ESCA47/ProGCCv3-hhlprotos/(list of files, cad)

Other CAD files:
progcc_v3_libs/docs/guilikit source materials/GL18 GuliKit Electromagnetic joystick PCB package library/GL18 Joystick.DWG
