ESCA47/ProGCCv3-hhlprotos/progcc_v3_main/procon_gcc_main_pcb.kicad_pcb

## KiCad design progcc_v3_main/procon_gcc_main_pcb.kicad_pcb (2023-06-27)

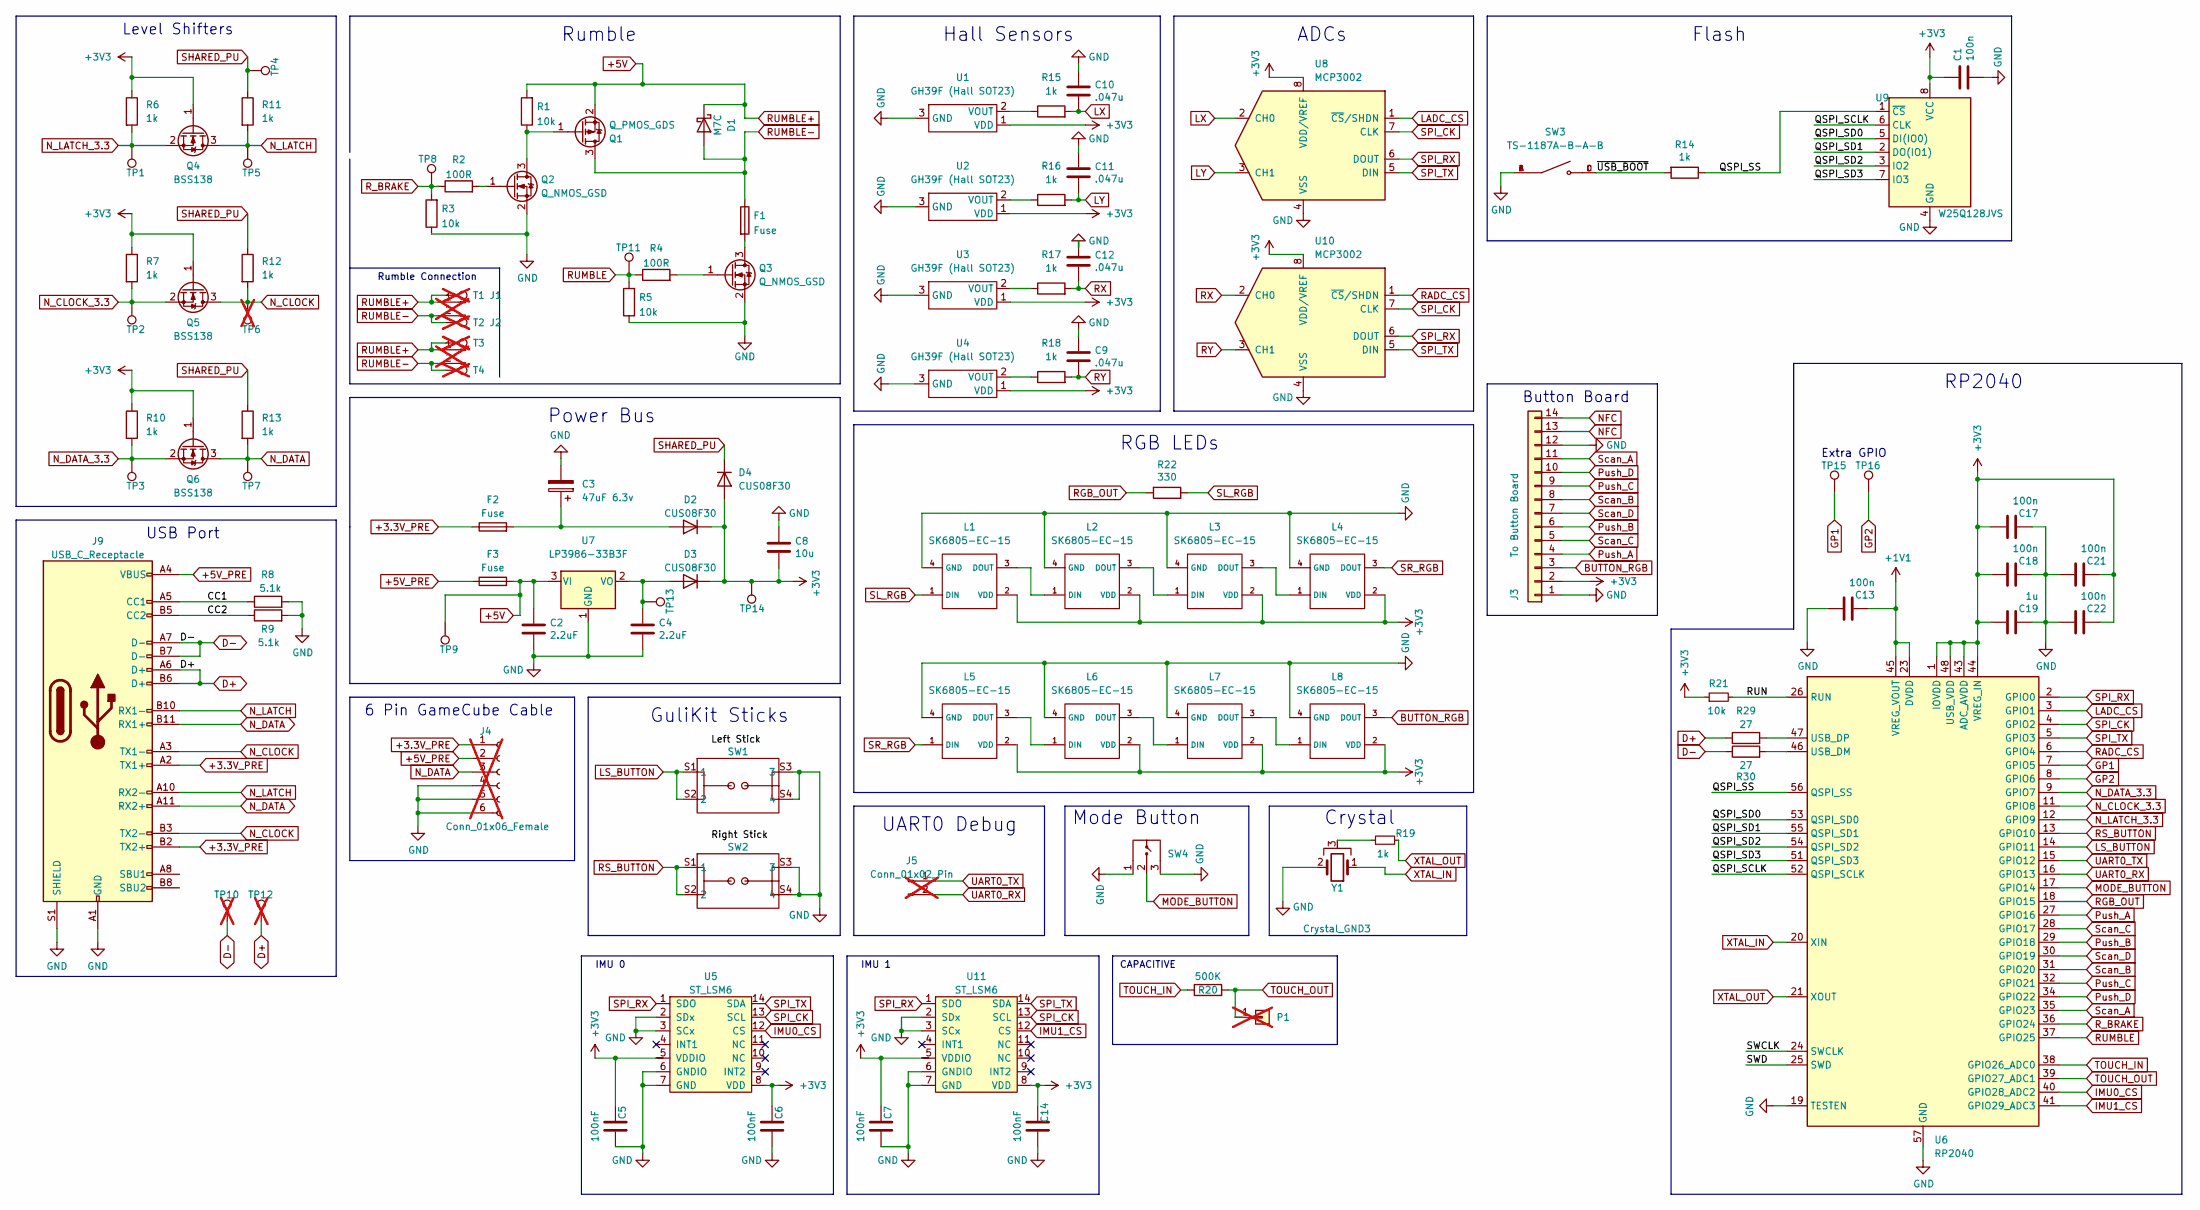
[picture p1: schematic procon_gcc_main_pcb.kicad_sch, ProGCC v3 Main Board]

Parts:
C1, C13, C17, C18, C21, C22: 100n; C_0402_1005Metric
C2, C4: 2.2uF; C_0603_1608Metric
C3: 47uF 6.3v; CP_EIA-3216-18_Kemet-A
C5, C6, C7, C14: 100nF; C_0603_1608Metric; LCSC C1525
C8: 10u; C_0603_1608Metric
C9, C10, C11, C12: .047u; C_0603_1608Metric_Pad1.08x0.95mm_HandSolder; LCSC C15849
C19: 1u; C_0402_1005Metric
D1: M7C; D_SOD-123; MPN B5819W SL; LCSC C8598
D2, D3, D4: CUS08F30; D_SOD-323_HandSoldering; MPN CUS08F30
F1, F2, F3: Fuse; Fuse_1206_3216Metric_Pad1.42x1.75mm_HandSolder; LCSC C69680
J1, J2: Rumble; rumble_pins; not fitted
J3: To Button Board; molex_5051101492_14P; MPN molex_5051101492_14P
J4: Conn_01x06_Female; GCC_Header_Straight_1x06_Pitch2.00mm; not fitted
J5: Conn_01x02_Pin; PinHeader_1x02_P2.00mm_Vertical; not fitted
J9: USB_C_Receptacle; Shou Han Type-C 24P QCHT; MPN Shou Han Type-C 24P QCHT
L1, L2, L3, L4, L5, L6, L7, L8: SK6805-EC-15; MPN SK6805-EC-15
P1: Endpoint; PinHeader_1x01_P2.54mm_Vertical; not fitted
Q1: Q_PMOS_GDS; SOT-23; MPN AO3401A; LCSC C15127
Q2, Q3: Q_NMOS_GSD; SOT-23; MPN AO3400A; LCSC C20917
Q4, Q5, Q6: BSS138; SOT-23; MPN BSS138
R1, R3, R5: 10k; R_0402_1005Metric; LCSC C25804
R2, R4: 100R; R_0402_1005Metric; LCSC C22775
R6, R7, R10, R11, R12, R13: 1k; R_0603_1608Metric_Pad0.98x0.95mm_HandSolder
R8, R9: 5.1k; R_0603_1608Metric_Pad0.98x0.95mm_HandSolder
R14, R15, R16, R17, R18, R19: 1k; R_0402_1005Metric
R20: 500K; R_0402_1005Metric; LCSC C11616
R21: 10k; R_0402_1005Metric
R22: 330; R_0402_1005Metric
R29, R30: 27; R_0402_1005Metric
SW1, SW2: GL18_SW; GL18; MPN GL18
SW3: TS-1187A-B-A-B; SW_TS-1187A-B-A-B; PARTREV A0
SW4: TS35CA; MPN TS35CA
T1, T2, T3, T4: 36-8730; KS_8730; not fitted
TP1, TP2, TP3, TP4, TP5, TP7, TP8, TP9, TP11, TP13, TP14, TP15, TP16: TestPoint; TestPoint_Pad_D1.5mm
TP6, TP10, TP12: TestPoint; TestPoint_Pad_D1.5mm; not fitted
U1, U2, U3, U4: GH39F (Hall SOT23); GH39F; MPN GH39F
U5, U11: ST_LSM6; LGA14; MPN LSM6DSRTR; LCSC C784817
U6: RP2040; QFN-56-1EP_7x7mm_P0.4mm_EP3.2x3.2mm; MPN RP2040
U7: LP3986-33B3F; SOT-23; MPN LP3986-33B3F; LCSC Part Number C387689
U8, U10: MCP3002; SOIC-8_3.9x4.9mm_P1.27mm; MPN MCP3002
U9: W25Q128JVS; SOIC-8_5.23x5.23mm_P1.27mm; MPN W25Q128JVS
Y1: Crystal_GND3; Resonator_SMD_Murata_CSTxExxV-3Pin_3.0x1.1mm; MPN CSTNE12M0GH5L000R0

Connections:
+1V1: C13.2, U6.23 (DVDD), U6.45 (VREG_VOUT), U6.50 (DVDD)
+3.3V_PRE: F2.1, J4.1, J9.A2 (TX1+), J9.B2 (TX2+)
+3V3: C1.1, C5.2, C6.2, C7.2, C8.2, C14.2, C17.1, C18.1, C19.1, C21.2, C22.2, D2.1 (K), D3.1 (K), D4.2 (A), J3.2, L1.2 (VDD), L2.2 (VDD), L3.2 (VDD), L4.2 (VDD), L5.2 (VDD), L6.2 (VDD), L7.2 (VDD), L8.2 (VDD), Q4.1 (G), Q5.1 (G), Q6.1 (G), R6.1, R7.1, R10.1, R21.1, TP14.1, U1.1 (VDD), U2.1 (VDD), U3.1 (VDD), U4.1 (VDD), U5.5 (VDDIO), U5.8 (VDD), U6.1 (IOVDD), U6.10 (IOVDD), U6.22 (IOVDD), U6.33 (IOVDD), U6.42 (IOVDD), U6.43 (ADC_AVDD), U6.44 (VREG_IN), U6.48 (USB_VDD), U6.49 (IOVDD), U8.8 (VDD/VREF), U9.8 (VCC), U10.8 (VDD/VREF), U11.5 (VDDIO), U11.8 (VDD)
+5V: C2.1, D1.1 (K), F3.2, J1.1, J2.1, Q1.2 (S), R1.2, T1.1, T3.1, TP9.1, U7.3 (VI)
+5V_PRE: F3.1, J4.2, J9.A4 (VBUS), J9.A9 (VBUS), J9.B4 (VBUS), J9.B9 (VBUS)
/CC1: J9.A5 (CC1), R8.1
/CC2: J9.B5 (CC2), R9.1
/QSPI_SCLK: U6.52 (QSPI_SCLK), U9.6 (CLK)
/QSPI_SD0: U6.53 (QSPI_SD0), U9.5 (DI(IO0))
/QSPI_SD1: U6.55 (QSPI_SD1), U9.2 (DO(IO1))
/QSPI_SD2: U6.54 (QSPI_SD2), U9.3 (IO2)
/QSPI_SD3: U6.51 (QSPI_SD3), U9.7 (IO3)
/QSPI_SS: R14.1, U6.56 (QSPI_SS), U9.1 (~CS)
/RUN: R21.2, U6.26 (RUN)
/SWCLK: U6.24 (SWCLK)
/SWD: U6.25 (SWD)
/~USB_BOOT: R14.2, SW3.C, SW3.D
BUTTON_RGB: J3.3, L8.3 (DOUT)
D+: J9.A6 (D+), J9.B6 (D+), R29.1, TP12.1
D-: J9.A7 (D-), J9.B7 (D-), R30.1, TP10.1
GND: C1.2, C2.2, C3.2, C4.2, C5.1, C6.1, C7.1, C8.1, C9.1, C10.1, C11.1, C12.1, C13.1, C14.1, C17.2, C18.2, C19.2, C21.1, C22.1, J3.1, J3.12, J4.4, J4.5, J4.6, J9.A1 (GND), J9.A12 (GND), J9.B1 (GND), J9.B12 (GND), J9.S1 (SHIELD), L1.4 (GND), L2.4 (GND), L3.4 (GND), L4.4 (GND), L5.4 (GND), L6.4 (GND), L7.4 (GND), L8.4 (GND), Q2.2 (S), Q3.2 (S), R3.1, R5.1, R8.2, R9.2, SW1.S3 (3), SW1.S4 (4), SW2.S3 (3), SW2.S4 (4), SW3.A, SW3.B, SW4.1, SW4.3, U1.3 (GND), U2.3 (GND), U3.3 (GND), U4.3 (GND), U5.2 (SDx), U5.3 (SCx), U5.6 (GNDIO), U5.7 (GND), U6.19 (TESTEN), U6.57 (GND), U7.1 (GND), U8.4 (VSS), U9.4 (GND), U10.4 (VSS), U11.2 (SDx), U11.3 (SCx), U11.6 (GNDIO), U11.7 (GND), Y1.2
GP1: TP15.1, U6.7 (GPIO5)
GP2: TP16.1, U6.8 (GPIO6)
IMU0_CS: U5.12 (CS), U6.40 (GPIO28_ADC2)
IMU1_CS: U6.41 (GPIO29_ADC3), U11.12 (CS)
LADC_CS: U6.3 (GPIO1), U8.1 (~CS/SHDN)
LS_BUTTON: SW1.S1 (1), SW1.S2 (2), U6.14 (GPIO11)
LX: C10.2, R15.2, U8.2 (CH0)
LY: C11.2, R16.2, U8.3 (CH1)
MODE_BUTTON: SW4.2, U6.17 (GPIO14)
NFC: J3.13, J3.14
N_CLOCK: J9.A3 (TX1-), J9.B3 (TX2-), Q5.3 (D), R12.2, TP6.1
N_CLOCK_3.3: Q5.2 (S), R7.2, TP2.1, U6.11 (GPIO8)
N_DATA: J4.3, J9.A11 (RX2+), J9.B11 (RX1+), Q6.3 (D), R13.2, TP7.1
N_DATA_3.3: Q6.2 (S), R10.2, TP3.1, U6.9 (GPIO7)
N_LATCH: J9.A10 (RX2-), J9.B10 (RX1-), Q4.3 (D), R11.2, TP5.1
N_LATCH_3.3: Q4.2 (S), R6.2, TP1.1, U6.12 (GPIO9)
unnamed: C3.1, D2.2 (A), F2.2
unnamed: C4.1, D3.2 (A), TP13.1, U7.2 (VO)
unnamed: L1.3 (DOUT), L2.1 (DIN)
unnamed: L2.3 (DOUT), L3.1 (DIN)
unnamed: L3.3 (DOUT), L4.1 (DIN)
unnamed: L5.3 (DOUT), L6.1 (DIN)
unnamed: L6.3 (DOUT), L7.1 (DIN)
unnamed: L7.3 (DOUT), L8.1 (DIN)
unnamed: Q1.1 (G), Q2.3 (D), R1.1
unnamed: Q2.1 (G), R2.2
unnamed: F1.2, Q3.3 (D)
unnamed: Q3.1 (G), R4.2
unnamed: R19.1, Y1.3
unnamed: R15.1, U1.2 (VOUT)
unnamed: R16.1, U2.2 (VOUT)
unnamed: R17.1, U3.2 (VOUT)
unnamed: R18.1, U4.2 (VOUT)
unnamed: R30.2, U6.46 (USB_DM)
unnamed: R29.2, U6.47 (USB_DP)
Push_A: J3.4, U6.27 (GPIO16)
Push_B: J3.6, U6.29 (GPIO18)
Push_C: J3.9, U6.32 (GPIO21)
Push_D: J3.10, U6.34 (GPIO22)
RADC_CS: U6.6 (GPIO4), U10.1 (~CS/SHDN)
RGB_OUT: R22.2, U6.18 (GPIO15)
RS_BUTTON: SW2.S1 (1), SW2.S2 (2), U6.13 (GPIO10)
RUMBLE: R4.1, R5.2, TP11.1, U6.37 (GPIO25)
RUMBLE-: D1.2 (A), F1.1, J1.2, J2.2, Q1.3 (D), T2.1, T4.1
RX: C12.2, R17.2, U10.2 (CH0)
RY: C9.2, R18.2, U10.3 (CH1)
R_BRAKE: R2.1, R3.2, TP8.1, U6.36 (GPIO24)
SHARED_PU: D4.1 (K), R11.1, R12.1, R13.1, TP4.1
SL_RGB: L1.1 (DIN), R22.1
SPI_CK: U5.13 (SCL), U6.4 (GPIO2), U8.7 (CLK), U10.7 (CLK), U11.13 (SCL)
SPI_RX: U5.1 (SDO), U6.2 (GPIO0), U8.6 (DOUT), U10.6 (DOUT), U11.1 (SDO)
SPI_TX: U5.14 (SDA), U6.5 (GPIO3), U8.5 (DIN), U10.5 (DIN), U11.14 (SDA)
SR_RGB: L4.3 (DOUT), L5.1 (DIN)
Scan_A: J3.11, U6.35 (GPIO23)
Scan_B: J3.8, U6.31 (GPIO20)
Scan_C: J3.5, U6.28 (GPIO17)
Scan_D: J3.7, U6.30 (GPIO19)
TOUCH_IN: R20.1, U6.38 (GPIO26_ADC0)
TOUCH_OUT: P1.1, R20.2, U6.39 (GPIO27_ADC1)
UART0_RX: J5.2, U6.16 (GPIO13)
UART0_TX: J5.1, U6.15 (GPIO12)
XTAL_IN: U6.20 (XIN), Y1.1
XTAL_OUT: R19.2, U6.21 (XOUT)

Notes on the sheet:
Flash
Crystal
IMU 1
Button Board
CAPACITIVE
Extra GPIO
Rumble Connection
IMU 0
RGB LEDs
RP2040
UART0 Debug
GuliKit Sticks
Hall Sensors
Mode Button
Power Bus
ADCs
Level Shifters
Rumble
USB Port
6 Pin GameCube Cable

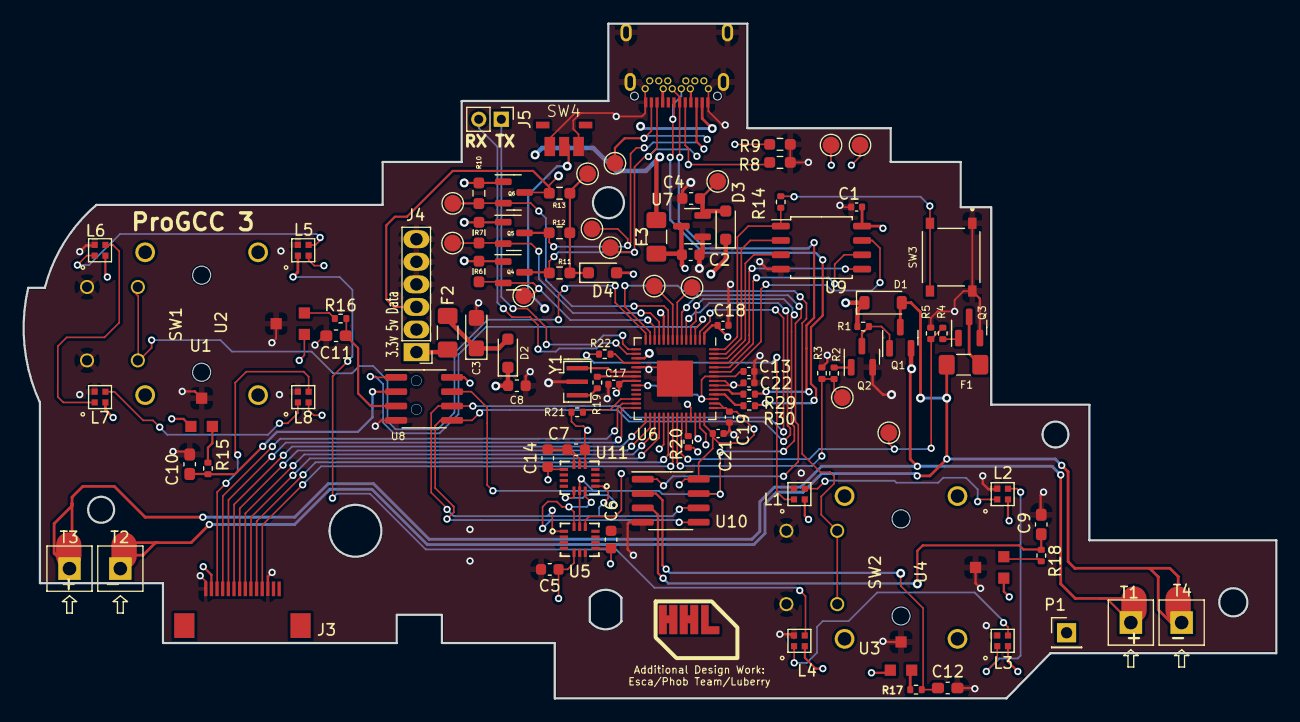
[picture p2: board procon_gcc_main_pcb.kicad_pcb from above]

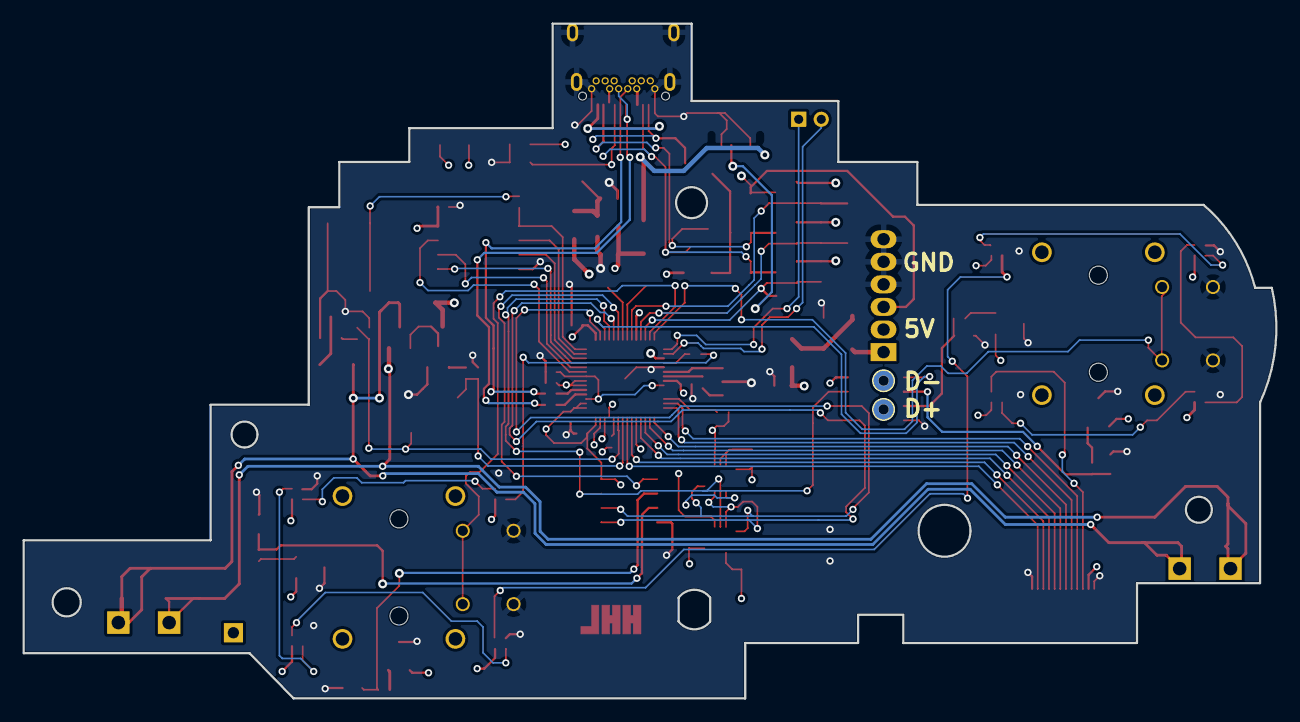
[picture p3: board procon_gcc_main_pcb.kicad_pcb from below]

Board: 4 copper layers, 110.9 x 59.7 mm, 107 parts (2 on the bottom side), 82 nets.
