ESCA47/ProGCCv3-hhlprotos/progcc_v3_button/procon_gcc_button_board.kicad_pcb

## KiCad design progcc_v3_button/procon_gcc_button_board.kicad_pcb (2023-06-07)

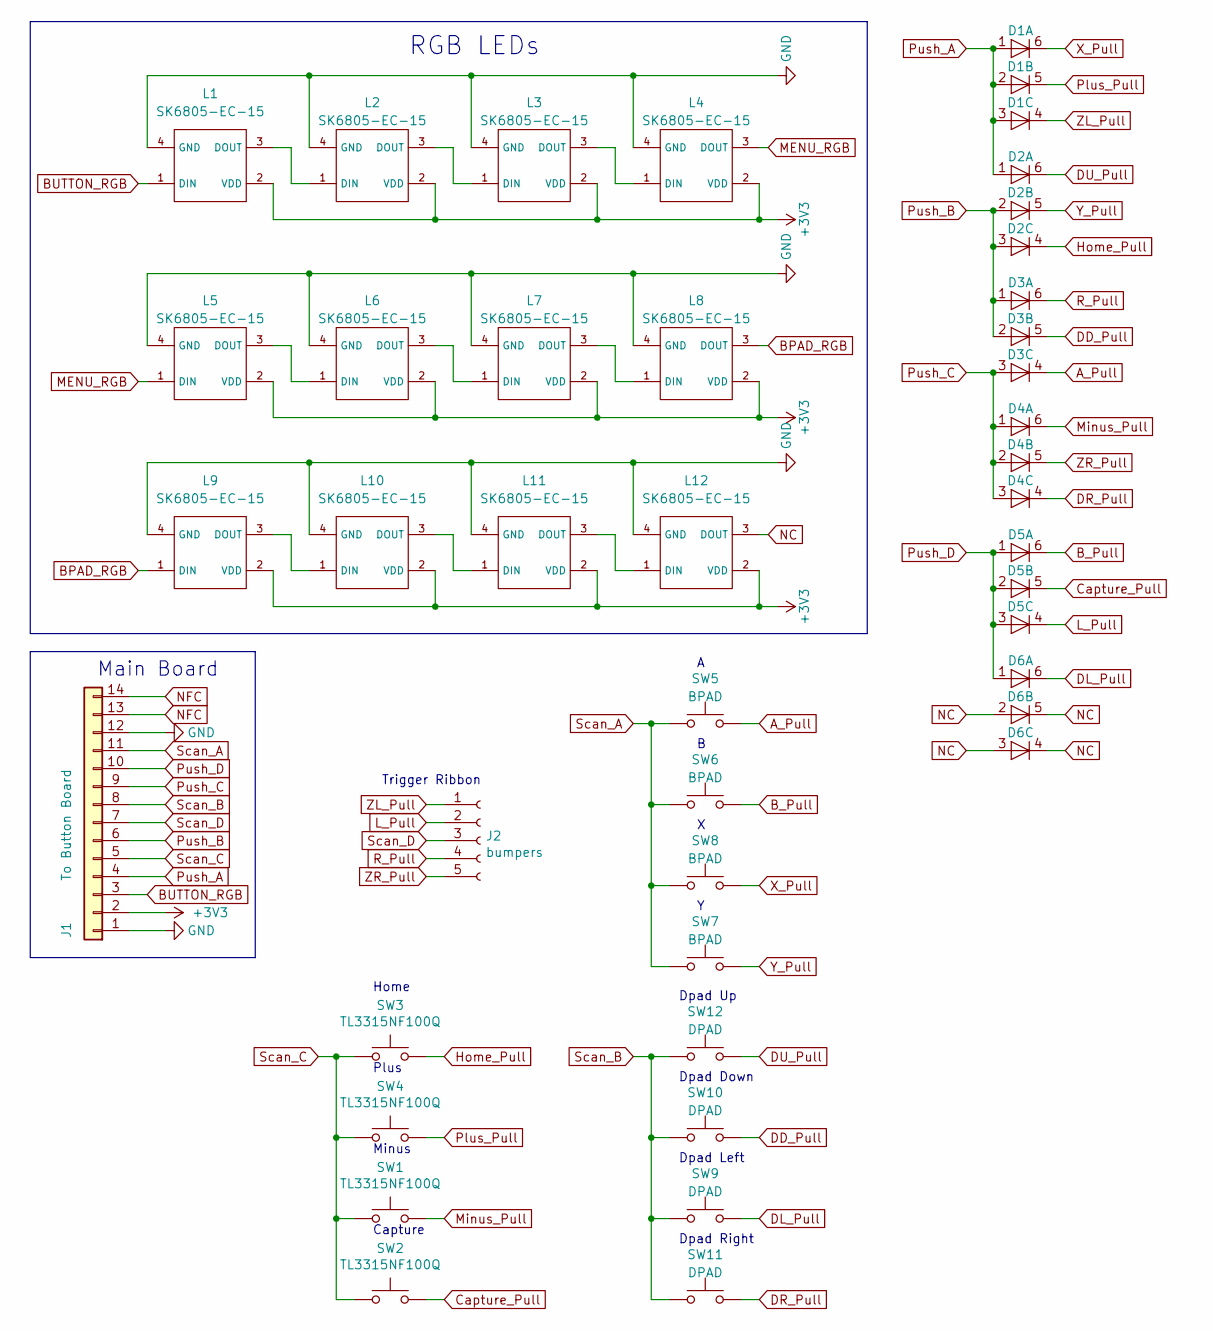
[picture p4: schematic procon_gcc_button_board.kicad_sch, ProGCC v3 Button Board]

Parts:
D1, D2, D3, D4, D5, D6: BAS16VY,115; SOT-363_SC-70-6
J1: To Button Board; molex_5051101492_14P
J2: bumpers; molex_5034800540; MPN molex_5034800540
L1, L2, L3, L4, L5, L6, L7, L8, L9, L10, L11, L12: SK6805-EC-15
SW1, SW2, SW3, SW4: TL3315NF100Q; TL3315NFxxxQ
SW5, SW6, SW7, SW8: BPAD; progcc_bpad
SW9, SW10, SW11, SW12: DPAD; progcc_dpad

Connections:
+3V3: J1.2, L1.2 (VDD), L2.2 (VDD), L3.2 (VDD), L4.2 (VDD), L5.2 (VDD), L6.2 (VDD), L7.2 (VDD), L8.2 (VDD), L9.2 (VDD), L10.2 (VDD), L11.2 (VDD), L12.2 (VDD)
A_Pull: D3.4 (K), SW5.2
BPAD_RGB: L8.3 (DOUT), L9.1 (DIN)
BUTTON_RGB: J1.3, L1.1 (DIN)
B_Pull: D5.6 (K), SW6.2
Capture_Pull: D5.5 (K), SW2.3, SW2.4
DD_Pull: D3.5 (K), SW10.2
DL_Pull: D6.6 (K), SW9.2
DR_Pull: D4.4 (K), SW11.2
DU_Pull: D2.6 (K), SW12.2
GND: J1.1, J1.12, L1.4 (GND), L2.4 (GND), L3.4 (GND), L4.4 (GND), L5.4 (GND), L6.4 (GND), L7.4 (GND), L8.4 (GND), L9.4 (GND), L10.4 (GND), L11.4 (GND), L12.4 (GND)
Home_Pull: D2.4 (K), SW3.3, SW3.4
L_Pull: D5.4 (K), J2.2
MENU_RGB: L4.3 (DOUT), L5.1 (DIN)
Minus_Pull: D4.6 (K), SW1.3, SW1.4
NC: D6.2 (A), D6.3 (A), D6.4 (K), D6.5 (K), L12.3 (DOUT)
NFC: J1.13, J1.14
unnamed: L1.3 (DOUT), L2.1 (DIN)
unnamed: L2.3 (DOUT), L3.1 (DIN)
unnamed: L3.3 (DOUT), L4.1 (DIN)
unnamed: L5.3 (DOUT), L6.1 (DIN)
unnamed: L6.3 (DOUT), L7.1 (DIN)
unnamed: L7.3 (DOUT), L8.1 (DIN)
unnamed: L9.3 (DOUT), L10.1 (DIN)
unnamed: L10.3 (DOUT), L11.1 (DIN)
unnamed: L11.3 (DOUT), L12.1 (DIN)
Plus_Pull: D1.5 (K), SW4.3, SW4.4
Push_A: D1.1 (A), D1.2 (A), D1.3 (A), D2.1 (A), J1.4
Push_B: D2.2 (A), D2.3 (A), D3.1 (A), D3.2 (A), J1.6
Push_C: D3.3 (A), D4.1 (A), D4.2 (A), D4.3 (A), J1.9
Push_D: D5.1 (A), D5.2 (A), D5.3 (A), D6.1 (A), J1.10
R_Pull: D3.6 (K), J2.4
Scan_A: J1.11, SW5.1, SW6.1, SW7.1, SW8.1
Scan_B: J1.8, SW9.1, SW10.1, SW11.1, SW12.1
Scan_C: J1.5, SW1.1, SW1.2, SW2.1, SW2.2, SW3.1, SW3.2, SW4.1, SW4.2
Scan_D: J1.7, J2.3
X_Pull: D1.6 (K), SW8.2
Y_Pull: D2.5 (K), SW7.2
ZL_Pull: D1.4 (K), J2.1
ZR_Pull: D4.5 (K), J2.5

Notes on the sheet:
Plus
Capture
Dpad Right
Main Board
Dpad Up
Dpad Down
Trigger Ribbon
Dpad Left
Home
Minus
RGB LEDs

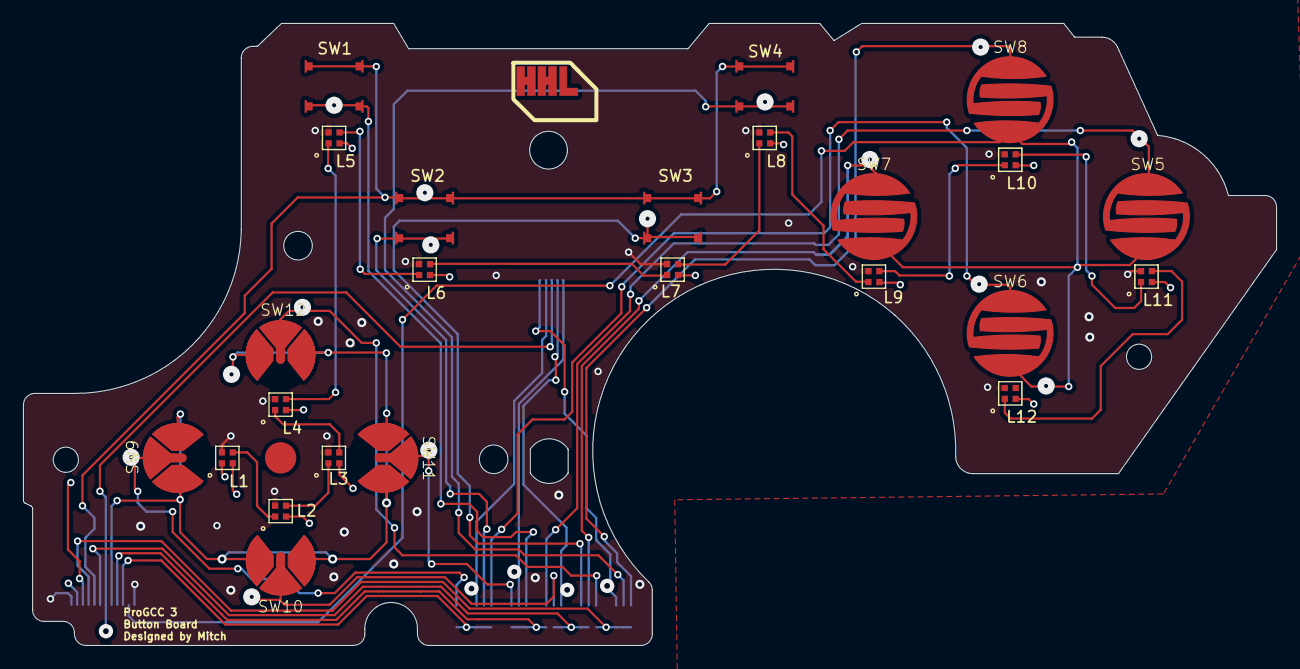
[picture p5: board procon_gcc_button_board.kicad_pcb from above]

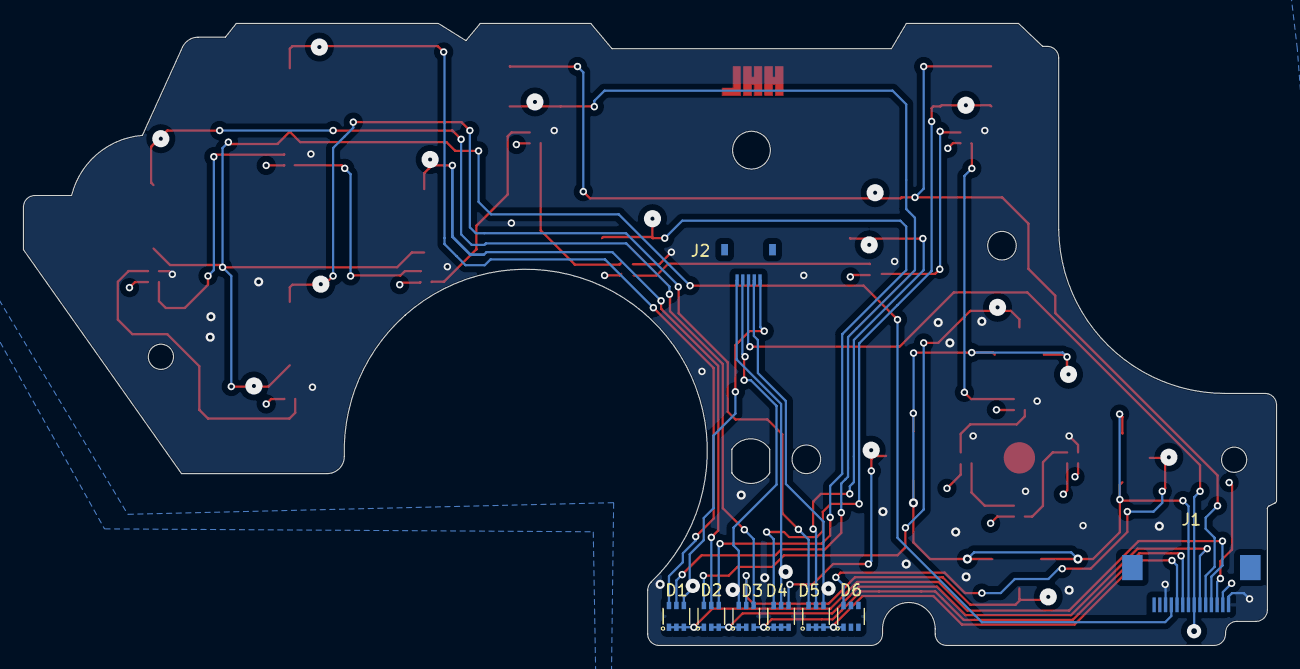
[picture p6: board procon_gcc_button_board.kicad_pcb from below]

Board: 4 copper layers, 109.4 x 54.3 mm, 32 parts (8 on the bottom side), 40 nets.
