ESCA47/ProGCCv3-hhlprotos/(commit log)

2023-03-09 added screw in terminals
    pushing this to have a branch before the mapping changes
2023-03-09 Matrix Rewire for front boards
    Swapped from direct to a matrix layout to support oem front boards
    [procon_gcc_main_pcb.kicad_sch]
2023-03-11 Update naming schema
    [GL18 Joystick.DWG, Phob2_Bom2.csv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]
2023-03-11 all libraries fixed+hole positioning changes
    fixed the screw points to be more accurate as well add a front bracket keepout to help with the future reroute
    [progcc_keepout.dxf]
2023-03-19 Moved components+setup for reroute
    hopefully fixed bad library dependencies too
    [cstick clearance.dxf]
2023-03-20 Major reorganization
    Unlink local folder name schema
    Organize libs into proper folder structure
    [GL18 Joystick.DWG, Phob2_Bom2.csv]
2023-04-12 Lots of schematic changes and upgrades
    Good luck :P
    [procon_gcc_main_pcb.kicad_sch]
2023-04-14 some schematic fixes+some positioning
    [procon_gcc_main_pcb.kicad_pcb, procon_gcc_main_pcb.kicad_sch]
2023-04-15 Schematic finalization
    [procon_gcc_main_pcb.kicad_pcb, procon_gcc_main_pcb.kicad_sch]
2023-04-15 More schematic fixes
    Added some more schematic items, grouped RP2040 with caps on PCB.
    [procon_gcc_main_pcb.kicad_pcb, procon_gcc_main_pcb.kicad_sch]
2023-04-24 some positioning changes+fP adjustments
    [procon_gcc_main_pcb.kicad_pcb, procon_gcc_main_pcb.kicad_sch]
2023-04-27 USB C routing area
    [procon_gcc_main_pcb.kicad_pcb]
2023-05-03 major routing
    most of the board is routed minus a couple bits
    [procon_gcc_main_pcb.kicad_pcb, procon_gcc_main_pcb.kicad_sch]
2023-05-05 Kicad 7 and Routing
    More routing done
    Updated to Kicad 7 file types
    [procon_gcc_main_pcb.kicad_pcb, procon_gcc_main_pcb.kicad_sch]
2023-05-06 Update button board
    [procon_gcc_button_board.kicad_pcb, procon_gcc_button_board.kicad_sch, procon_gcc_main_pcb.kicad_pcb, procon_gcc_main_pcb.kicad_sch]
2023-05-06 Update Pads and DRC
    [procon_gcc_button_board.kicad_pcb]
2023-05-06 Production files
    [procon_gcc_button_board-B_Courtyard.gbr, procon_gcc_button_board-B_Cu.gbr, procon_gcc_button_board-B_Fab.gbr, procon_gcc_button_board-B_Mask.gbr, procon_gcc_button_board-B_Paste.gbr, procon_gcc_button_board-B_Silkscreen.gbr, procon_gcc_button_board-Edge_Cuts.gbr, procon_gcc_button_board-F_Courtyard.gbr]
2023-05-06 Remove old production
    [procon_gcc_main_pcb-B_Courtyard.gbr, procon_gcc_main_pcb-B_Cu.gbr, procon_gcc_main_pcb-B_Fab.gbr, procon_gcc_main_pcb-B_Mask.gbr, procon_gcc_main_pcb-B_Paste.gbr, procon_gcc_main_pcb-B_Silkscreen.gbr, procon_gcc_main_pcb-Edge_Cuts.gbr, procon_gcc_main_pcb-F_Courtyard.gbr]
2023-05-06 Remove unneeded bom
    [procon_gcc_main_pcb-all-pos.csv]
2023-05-08 Update part #
    [procon_gcc_main_pcb.kicad_sch]
2023-05-09 Fixed missing trace
    Missing trace and N Channel mosfet fix
    [ProGCC V3 BOMs.xlsx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]
2023-05-26 Update proto
    - Update stick position
    - Adjust some screw position slightly
    - Fix schematic for Crystal and Rumble
    [procon_gcc_button_board.kicad_pcb, procon_gcc_button_board.kicad_sch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]
2023-05-27 Major updates
    -Revised button board outline
    -Added IMU for motion
    -Cleaned up traces on main board
    -Add test pads to button board
    [ProGCC V3 BOMs.xlsx, cstick clearance.dxf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]
2023-05-27 Add excel bom
    [ProGCC 3 r1 BOM.xlsx]
2023-05-27 Fix Stick positions (More!)
    [procon_gcc_main_pcb-B_Courtyard.gbr, procon_gcc_main_pcb-B_Cu.gbr, procon_gcc_main_pcb-B_Fab.gbr, procon_gcc_main_pcb-B_Mask.gbr, procon_gcc_main_pcb-B_Paste.gbr, procon_gcc_main_pcb-B_Silkscreen.gbr, procon_gcc_main_pcb-Edge_Cuts.gbr, procon_gcc_main_pcb-F_Courtyard.gbr]
2023-05-27 Update drill map
    [procon_gcc_main_pcb-NPTH-drl_map.gbr, procon_gcc_main_pcb-PTH-drl_map.gbr]
2023-06-07 50 qty test run update
    [procon_gcc_button_board-B_Courtyard.gbr, procon_gcc_button_board-B_Cu.gbr, procon_gcc_button_board-B_Fab.gbr, procon_gcc_button_board-B_Mask.gbr, procon_gcc_button_board-B_Paste.gbr, procon_gcc_button_board-B_Silkscreen.gbr, procon_gcc_button_board-Edge_Cuts.gbr, procon_gcc_button_board-F_Courtyard.gbr]
2023-06-27 Update production files
    [ProGCC 3 r1 BOM.xlsx, procon_gcc_button_board.csv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]
